davidbelliott/rfid/hardware/rfid-emulator.kicad_pcb

## KiCad design hardware/rfid-emulator.kicad_pcb (2019-11-23)

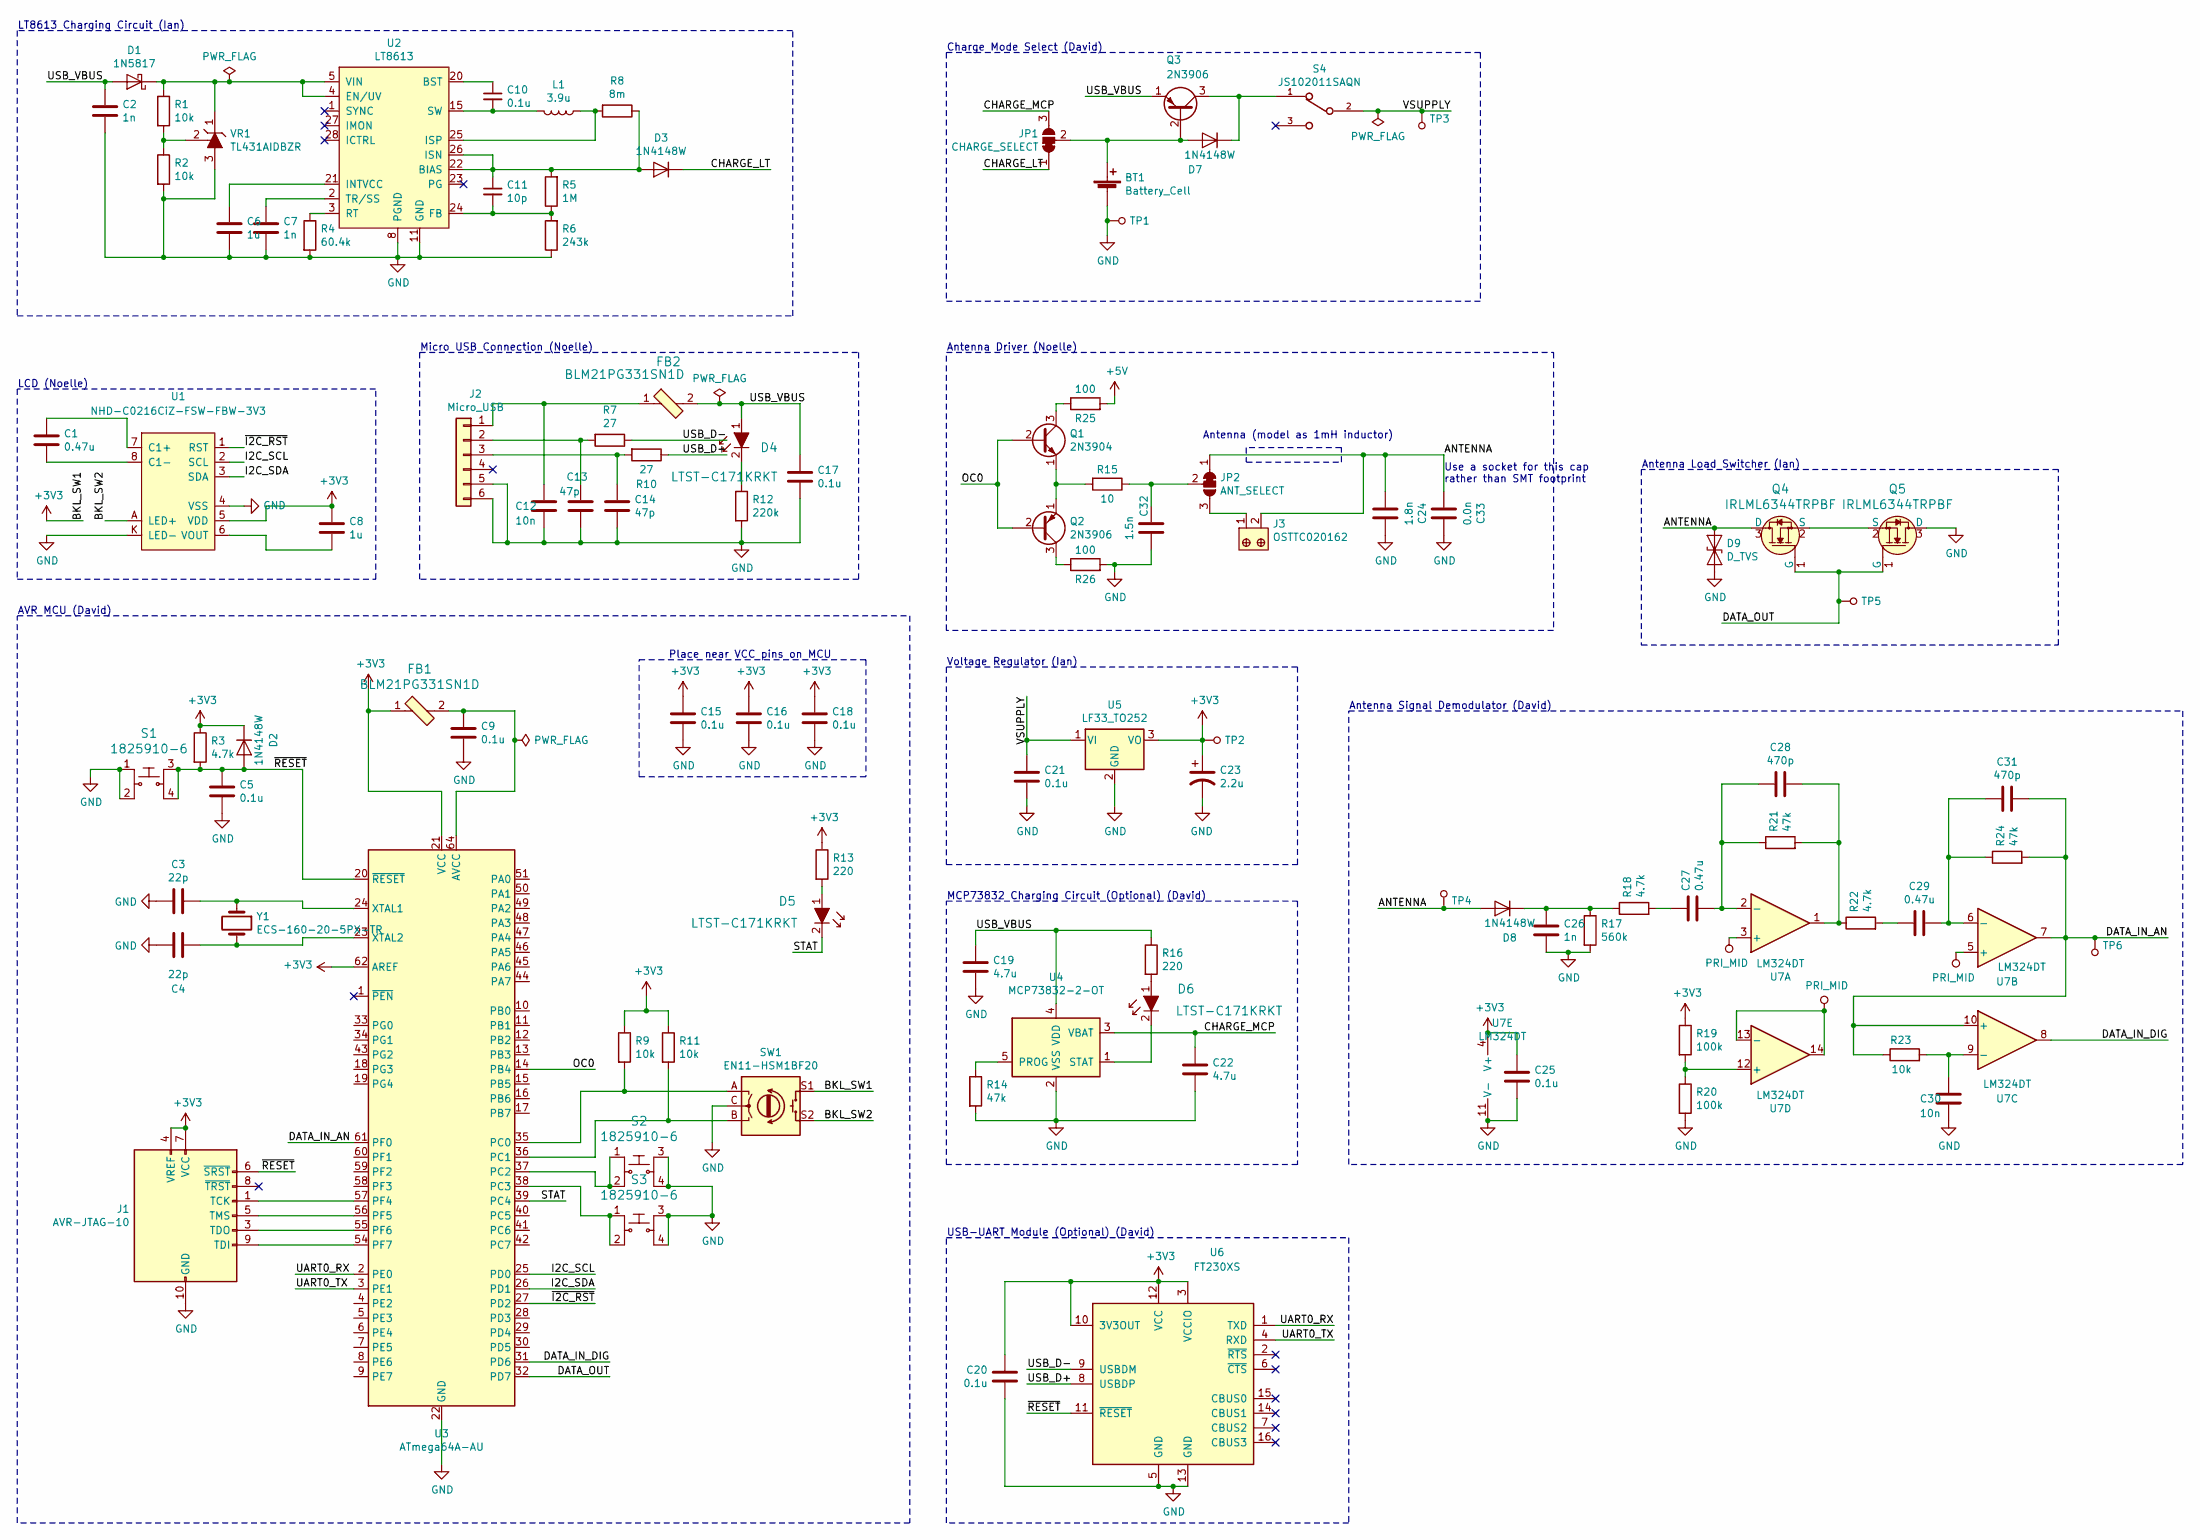
[picture p1: schematic rfid-emulator.sch, RFID Reader and Emulator]

Parts:
BT1: Battery_Cell; KEYSTONE-3034; Part RJD2032C1
C1: 0.47u; C_0805_HandSoldering; Part C0805C474K5RECTU
C2, C7, C26: 1n; C_0805_HandSoldering
C3, C4: 22p; C_0805_HandSoldering
C5, C9, C10, C15, C16, C17, C18, C20, C21, C25: 0.1u; C_0805_HandSoldering; Part C0805C104Z5VACTU
C6, C8: 1u; C_0805_HandSoldering; Part CC0805ZRY5V8BB105
C11: 10p; C_0805_HandSoldering
C12, C30: 10n; C_0805_HandSoldering; Part C0805C103K1RAC7210
C13, C14: 47p; C_0805_HandSoldering; Part C0805C470J5GACTU
C19, C22: 4.7u; C_0805_HandSoldering; Part CC0805ZRY5V6BB475
C23: 2.2u; EEE-1VA2R2NR; Part EEE-1VA2R2NR
C24: 1.8n; Socket_Strip_Straight_1x02_Pitch2.54mm
C27, C29: 0.47u; C_0805_HandSoldering
C28, C31: 470p; C_0805_HandSoldering
C32: 1.5n; C_0805_HandSoldering
C33: 0.0n; Socket_Strip_Straight_1x02_Pitch2.54mm
D1: 1N5817; D_DO-41_SOD81_P10.16mm_Horizontal
D2, D3, D7, D8: 1N4148W; D_SOD-123
D4, D5, D6: LTST-C171KRKT; 0805; MPN LTST-C171KRKT; Digi-Key_PN 160-1427-1-ND
D9: D_TVS; DO-219AD; Part MSP3V3-M3/89A
FB1, FB2: BLM21PG331SN1D; 0805; MPN BLM21PG331SN1D; Digi-Key_PN 490-5988-1-ND
J1: AVR-JTAG-10; PinHeader_2x5_P2.54mm_Drill1.2mm; Part 302-S101
J2: Micro_USB; USB_Micro-B_Molex_47346-0001; Part Molex 47346-0001
J3: OSTTC020162; Term_Block_1x2_P5mm; MPN OSTTC020162; Digi-Key_PN ED2600-ND
JP1: CHARGE_SELECT; SolderJumper-3_P1.3mm_Open_RoundedPad1.0x1.5mm
JP2: ANT_SELECT; SolderJumper-3_P1.3mm_Open_RoundedPad1.0x1.5mm
L1: 3.9u; CDRH6D28; Part CDRH6D28NP-3R9NC
Q1: 2N3904; TO-92-3
Q2, Q3: 2N3906; TO-92-3
Q4, Q5: IRLML6344TRPBF; SOT-23-3; MPN IRLML6344TRPBF; Digi-Key_PN IRLML6344TRPBFCT-ND
R1, R2, R9, R11, R23: 10k; R_0805_HandSoldering
R3, R18, R22: 4.7k; R_0805_HandSoldering
R4: 60.4k; R_0805_HandSoldering
R5: 1M; R_0805_HandSoldering
R6: 243k; R_0805_HandSoldering
R7, R10: 27; R_0805_HandSoldering
R8: 8m; R_0805_HandSoldering
R12: 220k; R_0805_HandSoldering
R13, R16: 220; R_0805_HandSoldering
R14, R21, R24: 47k; R_0805_HandSoldering
R15: 10; R_0805_HandSoldering
R17: 560k; R_0805_HandSoldering
R19, R20: 100k; R_0805_HandSoldering
R25, R26: 100; R_0805_HandSoldering
S1, S2, S3: 1825910-6; Switch_Tactile_THT_6x6mm; MPN 1825910-6; Digi-Key_PN 450-1650-ND
S4: JS102011SAQN; SW_JS102011SAQN
SW1: EN11-HSM1BF20
TP1: 5001; Test_Point_D1.02mm; MPN 5001; Digi-Key_PN 36-5001-ND
TP2, TP3: 5000; Test_Point_D1.02mm; MPN 5000; Digi-Key_PN 36-5000-ND
TP4, TP5, TP6: 5002; Test_Point_D1.02mm; MPN 5002; Digi-Key_PN 36-5002-ND
U1: NHD-C0216CiZ-FSW-FBW-3V3; NHD-C0216CiZ
U2: LT8613; QFN-28-1EP_3x6mm_Pitch0.5mm
U3: ATmega64A-AU; TQFP-64_14x14mm_Pitch0.8mm
U4: MCP73832-2-OT; SOT-23-5_HandSoldering
U5: LF33_TO252; TO-220-3_Horizontal
U6: FT230XS; SSOP-16_3.9x4.9mm_P0.635mm
U7: LM324DT; SOIC-14_W3.9mm
VR1: TL431AIDBZR; SOT-23-3; MPN TL431AIDBZR; Digi-Key_PN 296-17329-1-ND
Y1: ECS-160-20-5PX-TR; XTAL_ECS-160-20-5PX-TR

Connections:
+3V3: C8.1, C15.1, C16.1, C18.1, C20.1, C23.1, C25.1, D2.1 (K), FB1.1, J1.4 (VREF), J1.7 (VCC), R3.1, R9.1, R11.1, R13.1, R19.1, SW1.S1, TP2.1, U1.5 (VDD), U3.21 (VCC), U3.52 (VCC), U3.62 (AREF), U5.3 (VO), U6.3 (VCCIO), U6.10 (3V3OUT), U6.12 (VCC), U7.4 (V+)
+5V: R25.2
/ANTENNA: C24.2, C33.2, D8.2 (A), D9.1 (A1), J3.2, JP2.1 (A), Q4.3 (D), TP4.1
/BKL_SW2: SW1.S2, U1.A (LED+)
/CHARGE_LT: D3.1 (K), JP1.1 (A)
/CHARGE_MCP: C22.1, JP1.3 (B), U4.3 (VBAT)
/DATA_IN_AN: C31.1, R23.1, R24.2, TP6.1, U3.61 (PF0), U7.7, U7.10 (+)
/DATA_IN_DIG: U3.31 (PD6), U7.8
/DATA_OUT: Q4.1 (G), Q5.1 (G), TP5.1, U3.32 (PD7)
/I2C_SCL: U1.2 (SCL), U3.25 (PD0)
/I2C_SDA: U1.3 (SDA), U3.26 (PD1)
/OC0: Q1.2 (B), Q2.2 (B), U3.14 (PB4)
/STAT: D5.2, U3.39 (PC4)
/UART0_RX: U3.2 (PE0), U6.1 (TXD)
/UART0_TX: U3.3 (PE1), U6.4 (RXD)
/USB_D+: R10.1, U6.8 (USBDP)
/USB_D-: R7.1, U6.9 (USBDM)
/USB_VBUS: C2.2, C17.1, C19.1, D1.2 (A), D4.1, FB2.2, Q3.1 (E), R16.1, U4.4 (VDD)
/VSUPPLY: C21.1, S4.2, TP3.1, U5.1 (VI)
/~I2C_RST~: U1.1 (RST), U3.27 (PD2)
/~RESET~: C5.1, D2.2 (A), J1.6 (~SRST), R3.2, S1.3, S1.4, U3.20 (~RESET), U6.11 (~RESET)
GND: BT1.2 (-), C2.1, C3.2, C4.2, C5.2, C6.2, C7.1, C9.2, C12.2, C13.2, C14.2, C15.2, C16.2, C17.2, C18.2, C19.2, C20.2, C21.2, C22.2, C23.2, C24.1, C25.2, C26.1, C30.2, C32.1, C33.1, D9.2 (A2), J1.2 (GND), J1.10 (GND), J2.5, J2.6, Q5.3 (D), R2.2, R4.2, R6.1, R12.2, R14.2, R17.2, R20.2, R26.2, S1.1, S1.2, S2.3, S2.4, S3.3, S3.4, SW1.C, TP1.1, U1.4 (VSS), U1.K (LED-), U2.8 (PGND), U2.11 (GND), U3.22 (GND), U3.53 (GND), U3.63 (GND), U4.2 (VSS), U5.2 (GND), U6.5 (GND), U6.13 (GND), U7.11 (V-), VR1.3 (A)
unnamed: BT1.1 (+), D7.2 (A), JP1.2 (C), Q3.2 (B)
unnamed: C1.1, U1.7 (C1+)
unnamed: C1.2, U1.8 (C1-)
unnamed: C3.1, U3.24 (XTAL1), Y1.1
unnamed: C4.1, U3.23 (XTAL2), Y1.2
unnamed: C6.1, U2.21 (INTVCC)
unnamed: C7.2, U2.2 (TR/SS)
unnamed: C8.2, U1.6 (VOUT)
unnamed: C9.1, FB1.2, U3.64 (AVCC)
unnamed: C10.1, U2.20 (BST)
unnamed: C10.2, L1.2, U2.15 (SW)
unnamed: C11.1, D3.2 (A), R5.2, R8.1, U2.22 (BIAS), U2.26 (ISN)
unnamed: C11.2, R5.1, R6.2, U2.24 (FB)
unnamed: C12.1, FB2.1, J2.1
unnamed: C13.1, J2.2, R7.2
unnamed: C14.1, J2.3, R10.2
unnamed: C26.2, D8.1 (K), R17.1, R18.1
unnamed: C27.1, R18.2
unnamed: C27.2, C28.2, R21.1, U7.2 (-)
unnamed: C28.1, R21.2, R22.1, U7.1
unnamed: C29.1, C31.2, R24.1, U7.6 (-)
unnamed: C29.2, R22.2
unnamed: C30.1, R23.2, U7.9 (-)
unnamed: C32.2, JP2.2 (C), R15.1
unnamed: D1.1 (K), R1.1, U2.4 (EN/UV), U2.5 (VIN), VR1.1 (K)
unnamed: D4.2, R12.1
unnamed: D5.1, R13.2
unnamed: D6.1, R16.2
unnamed: D6.2, U4.1 (STAT)
unnamed: D7.1 (K), Q3.3 (C), S4.1
unnamed: J1.1 (TCK), U3.57 (PF4)
unnamed: J1.3 (TDO), U3.55 (PF6)
unnamed: J1.5 (TMS), U3.56 (PF5)
unnamed: J1.9 (TDI), U3.54 (PF7)
unnamed: J3.1, JP2.3 (B)
unnamed: L1.1, R8.2, U2.25 (ISP)
unnamed: Q1.1 (E), Q2.1 (E), R15.2
unnamed: Q1.3 (C), R25.1
unnamed: Q2.3 (C), R26.1
unnamed: Q4.2 (S), Q5.2 (S)
unnamed: R1.2, R2.1, VR1.2 (REF)
unnamed: R4.1, U2.3 (RT)
unnamed: R9.2, SW1.A, U3.35 (PC0)
unnamed: R11.2, SW1.B, U3.36 (PC1)
unnamed: R14.1, U4.5 (PROG)
unnamed: R19.2, R20.1, U7.12 (+)
unnamed: S2.1, S2.2, U3.37 (PC2)
unnamed: S3.1, S3.2, U3.38 (PC3)
PRI_MID: U7.3 (+), U7.5 (+), U7.13 (-), U7.14

Notes on the sheet:
Place near VCC pins on MCU
Use a socket for this cap rather than SMT footprint
USB-UART Module (Optional) (David)
LT8613 Charging Circuit (Ian)
Charge Mode Select (David)
Antenna Driver (Noelle)
Antenna Signal Demodulator (David)
Antenna Load Switcher (Ian)
AVR MCU (David)
MCP73832 Charging Circuit (Optional) (David)
Voltage Regulator (Ian)
LCD (Noelle)
Micro USB Connection (Noelle)
Antenna (model as 1mH inductor)

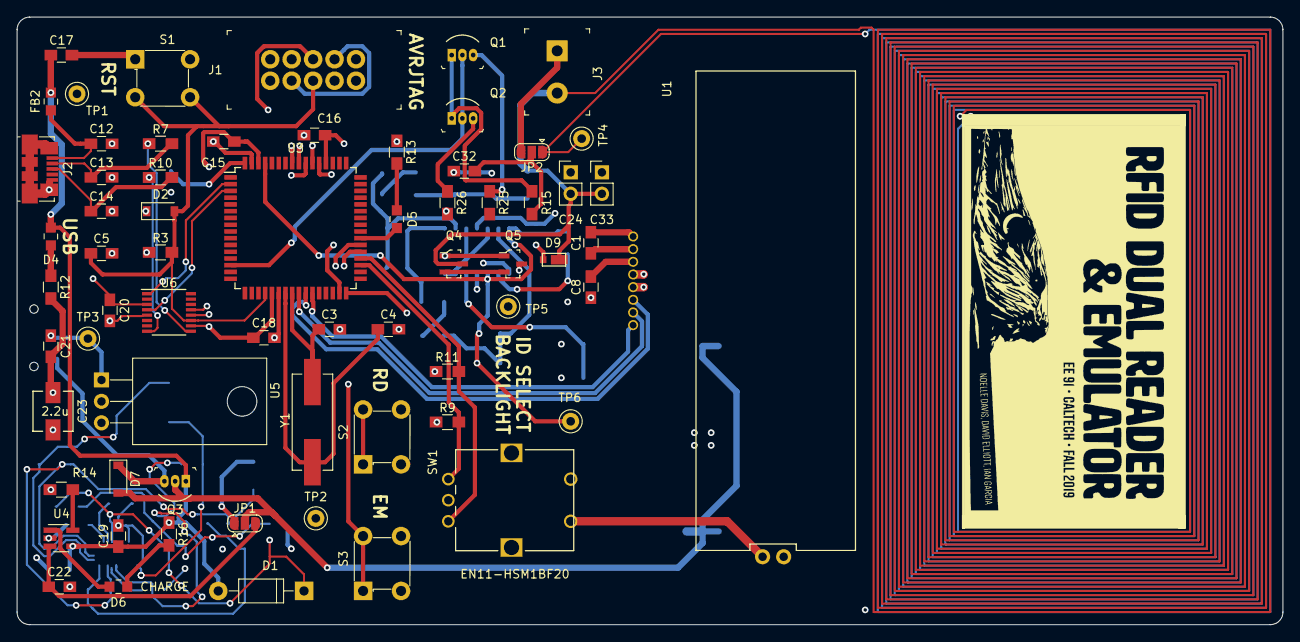
[picture p2: board rfid-emulator.kicad_pcb from above]

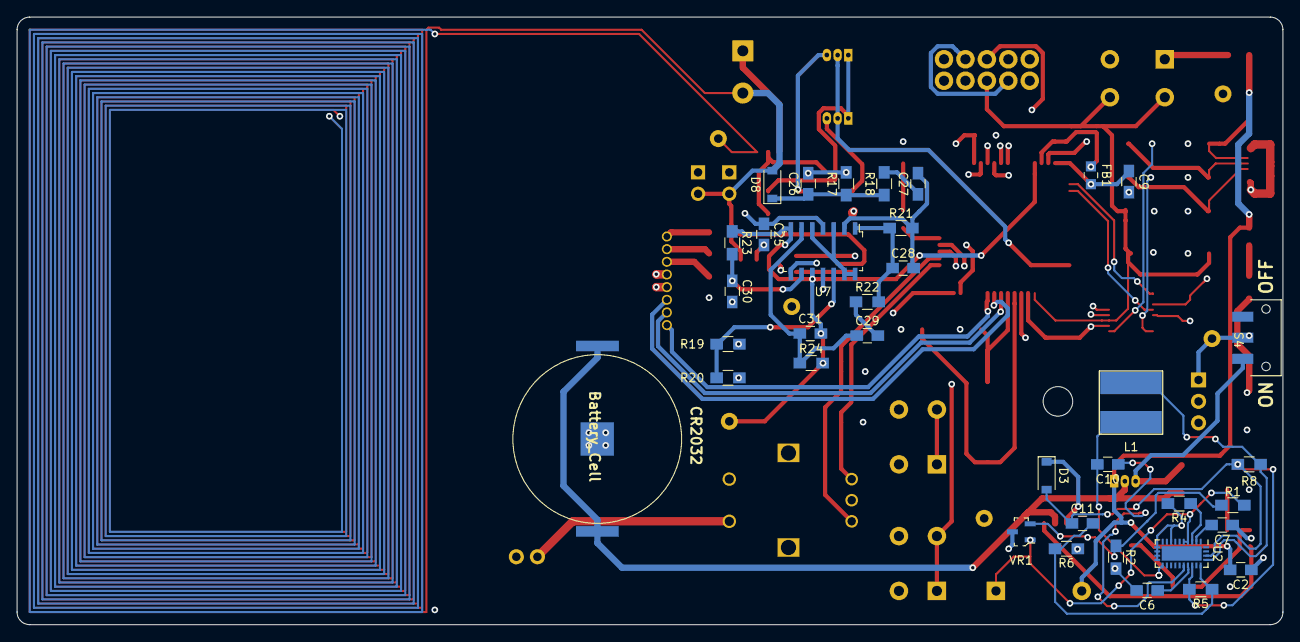
[picture p3: board rfid-emulator.kicad_pcb from below]

Board: 4 copper layers, 150.0 x 72.0 mm, 102 parts (36 on the bottom side), 70 nets.
