davidbelliott/rfid/(commit log)

2019-10-31 Move kicad files to hardware directory
    [rfid-emulator.kicad_pcb, rfid-emulator.sch]
2019-11-12 Update schematic with latest changes
    [rfid-emulator.sch]
2019-11-17 Update schematic to fix voltage supply, reflect prototyping changes
    [rfid-emulator.sch]
2019-11-18 Add footprints for some components missing them
    [rfid-emulator.sch]
2019-11-18 Add footprints for pretty much everything
    [rfid-emulator.sch]
2019-11-18 Layout for most parts
    [rfid-emulator.kicad_pcb, rfid-emulator.sch]
2019-11-18 Re-add Noelle's changes
    [rfid-emulator.kicad_pcb, rfid-emulator.sch]
2019-11-18 Ian changes rfid-emulator.kicad_pcb
    Added all traces and connections associated with the battery management system.
    [rfid-emulator.kicad_pcb]
2019-11-19 Finished driver and added antenna
    [rfid-emulator.kicad_pcb]
2019-11-19 Fix most DRC failures on PCB check
    [rfid-emulator.kicad_pcb, rfid-emulator.sch]
2019-11-22 Add test points and extra capacitor socket
    [rfid-emulator.kicad_pcb, rfid-emulator.sch]
2019-11-23 Add aux origin and fix unrounded corner on PCB
    [rfid-emulator.kicad_pcb]
2019-11-23 Added silkscreen beaver
    [rfid-emulator.kicad_pcb]
2019-11-23 Fixed name typo
    [rfid-emulator.kicad_pcb]
2019-12-01 Fix incorrect polarity and sample synchronization
    [rfid.c]
2019-12-09 added lcd i2c driver
2019-12-12 updated lcd driver for twi
2019-12-12 Fix bit_start neglected, driver frequency, running out of RAM
    [rfid.c]
2019-12-12 Add script to set fuse bits properly
2019-12-12 Add support for assembly source
2019-12-12 Placeholder for slots; make LCD use internal booster
2019-12-13 Add TWI driver code
2019-12-13 added encoder debouncing
2019-12-13 Add button debouncing
2019-12-13 Remove debug LED toggle and fix negative wraparound for slots
    [buttons.c, rfid.c]
2019-12-13 Stop erroneously disabling debouncing interrupt
2019-12-13 Fix customer ID/version number getting cut off
    [rfid.c, slots.c, slots.h, util.c, util.h]
2019-12-13 Better align display of slot contents; get rid of slot placeholder values
2019-12-13 Use EEPROM for persistent slot data storage
